infrapale/T2408_OC_Serial_WS2812/images/20240813-P8130287.jpg

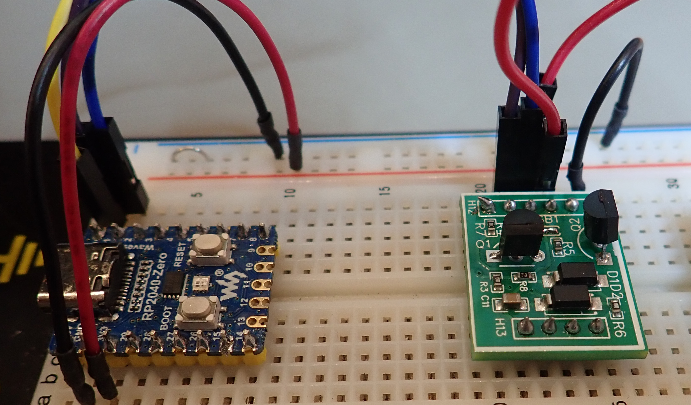
images/20240813-P8130287.jpg
