infrapale/T2408_OC_Serial_WS2812/(commit log)

2024-08-13 LED strip refined
2024-08-14 RGB level shifter circuit added
